robotronik/cdfr2024-carte-asservissement/README.md

# Carte d'asservissement Robotronik CDFR 2024

Projet Kicad qui a pour but de faire l'asservissement de la base roulante.
