robotronik/cdfr2024-carte-asservissement/cdfr25_imu/cdfr25_imu.kicad_pcb

## KiCad design cdfr25_imu/cdfr25_imu.kicad_pcb (2024-10-16)

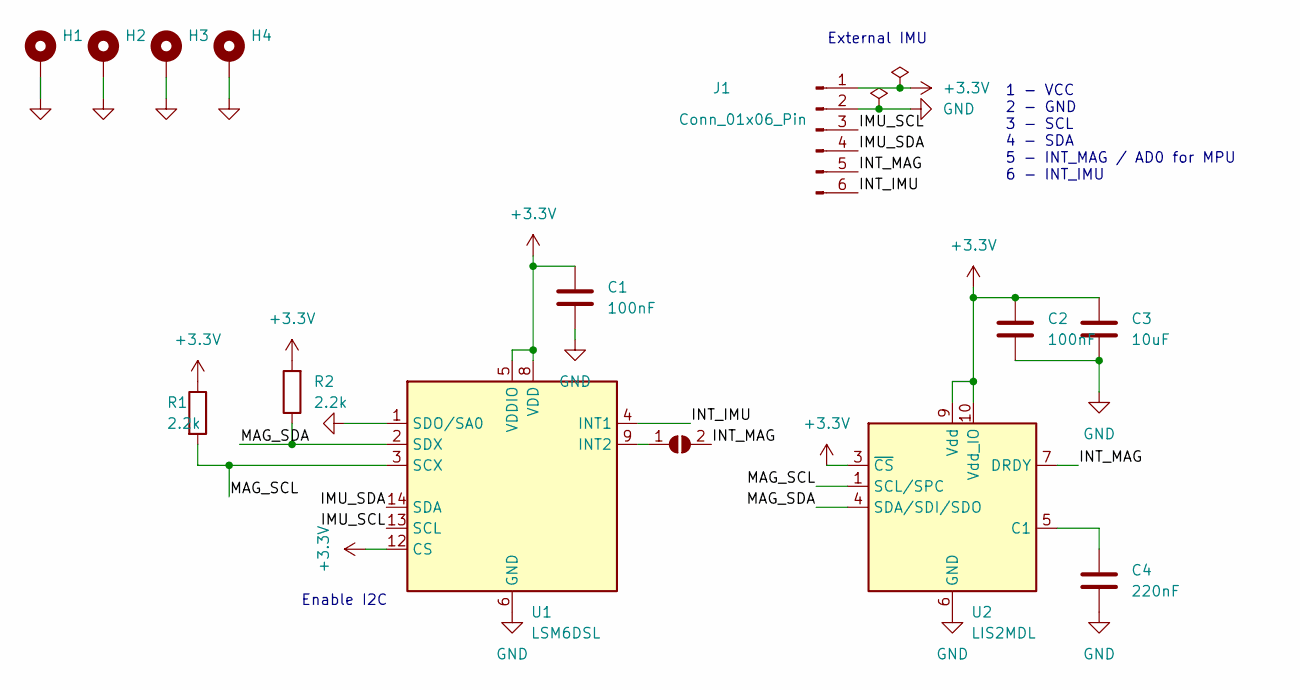
[picture p1: schematic cdfr25_imu.kicad_sch]

Parts:
C1, C2: 100nF; C_0805_2012Metric_Pad1.18x1.45mm_HandSolder
C3: 10uF; C_0805_2012Metric_Pad1.18x1.45mm_HandSolder
C4: 220nF; C_0805_2012Metric_Pad1.18x1.45mm_HandSolder
H1, H2, H3, H4: MountingHole_Pad; MountingHole_2.2mm_M2_Pad_Via
J1: Conn_01x06_Pin; PinHeader_1x06_P2.54mm_Vertical
JP1: SolderJumper_2_Open; SolderJumper-2_P1.3mm_Open_TrianglePad1.0x1.5mm
R1, R2: 2.2k; R_0805_2012Metric_Pad1.20x1.40mm_HandSolder
U1: LSM6DSL; LGA-14_3x2.5mm_P0.5mm_LayoutBorder3x4y
U2: LIS2MDL; LGA-12_2x2mm_P0.5mm

Connections:
+3.3V: C1.2, C2.2, C3.2, J1.1, R1.1, R2.2, U1.5 (VDDIO), U1.8 (VDD), U1.12 (CS), U2.3 (~CS), U2.9 (Vdd), U2.10 (Vdd_IO)
/IMU_SCL: J1.3, U1.13 (SCL)
/IMU_SDA: J1.4, U1.14 (SDA)
/INT_IMU: J1.6, U1.4 (INT1)
/INT_MAG: J1.5, JP1.2 (B), U2.7 (DRDY)
/MAG_SCL: R1.2, U1.3 (SCX), U2.1 (SCL/SPC)
/MAG_SDA: R2.1, U1.2 (SDX), U2.4 (SDA/SDI/SDO)
GND: C1.1, C2.1, C3.1, C4.1, H1.1, H2.1, H3.1, H4.1, J1.2, U1.1 (SDO/SA0), U1.6 (GND), U1.7 (GND), U2.6 (GND), U2.8 (GND)
unnamed: JP1.1 (A), U1.9 (INT2)
unnamed: C4.2, U2.5 (C1)

Notes on the sheet:
External IMU
Enable I2C
1 - VCC 2 - GND 3 - SCL 4 - SDA 5 - INT_MAG / AD0 for MPU 6 - INT_IMU

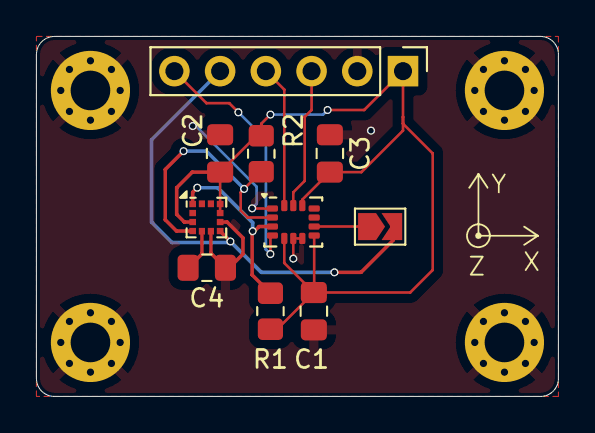
[picture p2: board cdfr25_imu.kicad_pcb from above]

Board: 2 copper layers, 29.0 x 20.0 mm, 14 parts (0 on the bottom side), 10 nets.
