robotronik/cdfr2024-carte-asservissement/cdfr24_asservissement/cdfr24_asservissement.kicad_pcb

## KiCad design cdfr24_asservissement/cdfr24_asservissement.kicad_pcb (2024-10-13)

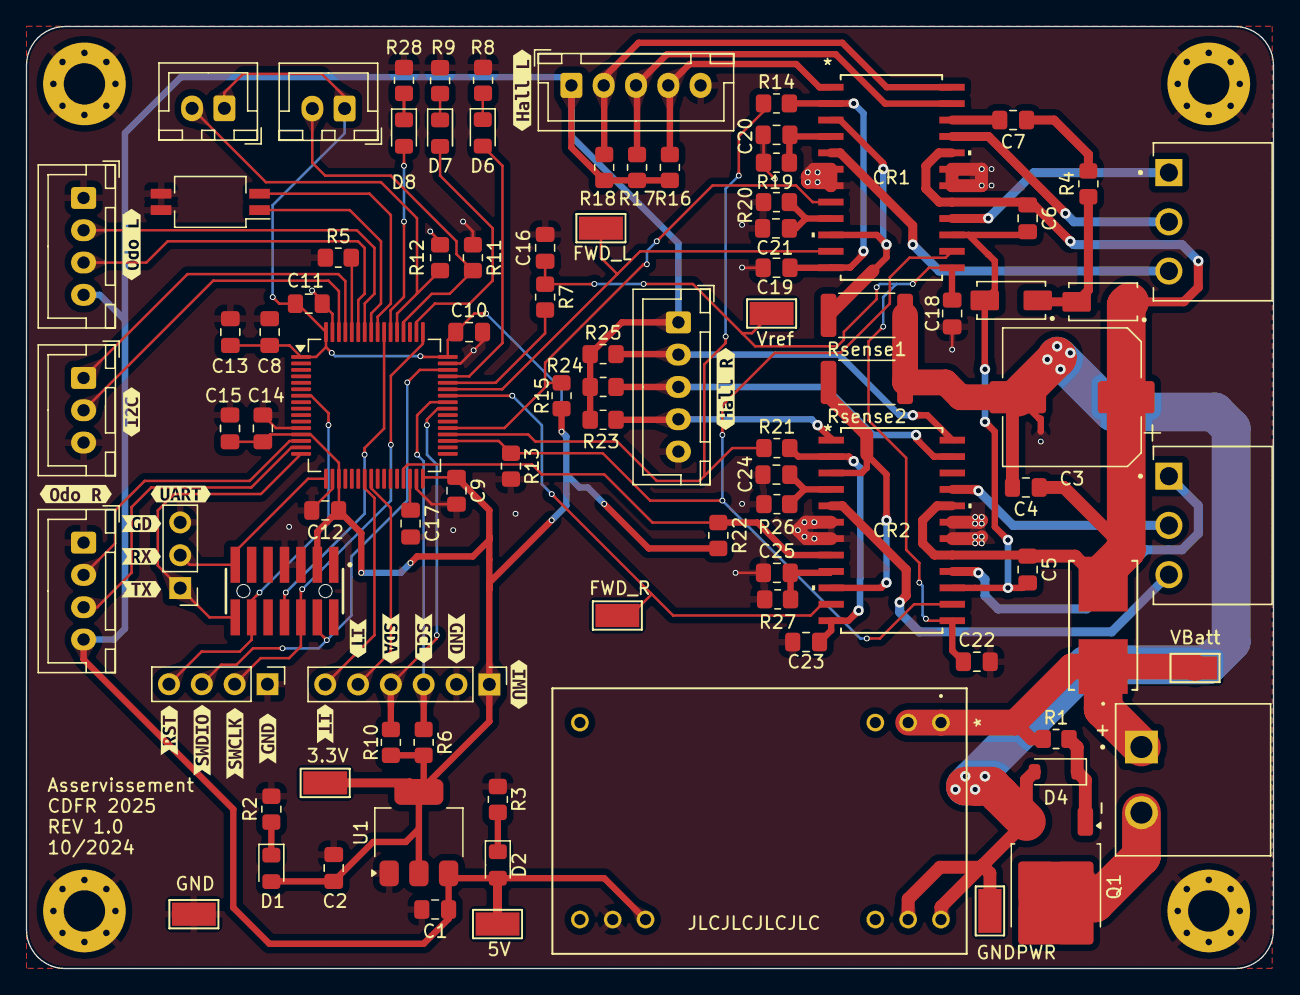
[picture p3: board cdfr24_asservissement.kicad_pcb from above]

Board: 2 copper layers, 96.5 x 72.9 mm, 117 parts (0 on the bottom side), 70 nets.

Parts:
C1, C8, C9, C10, C11, C12: 100nF; C_0805_2012Metric_Pad1.18x1.45mm_HandSolder
C2, C13: 10uF; C_0805_2012Metric_Pad1.18x1.45mm_HandSolder
C3: 220u; CP_Elec_10x10.5
C4, C5, C6, C18, C22: 100n; C_0805_2012Metric_Pad1.18x1.45mm_HandSolder
C7: 10n; C_0805_2012Metric_Pad1.18x1.45mm_HandSolder
C14, C21, C25: 10nF; C_0805_2012Metric_Pad1.18x1.45mm_HandSolder
C15: 1uF; C_0805_2012Metric_Pad1.18x1.45mm_HandSolder
C16: ...; C_0805_2012Metric_Pad1.18x1.45mm_HandSolder
C17: 4.7uF; C_0805_2012Metric_Pad1.18x1.45mm_HandSolder
C19, C23: 5.6n; C_0805_2012Metric_Pad1.18x1.45mm_HandSolder
C20, C24: 1nF; C_0805_2012Metric_Pad1.18x1.45mm_HandSolder
CR1, CR2: L6235D; SO-24_STM
D1, D2, D6, D7, D8: LED; LED_0805_2012Metric_Pad1.15x1.40mm_HandSolder
D3, D5: D_Filled; DIOM505270X240
D4: D_Zener; D_SOD-123
F1: 01550900M; FUSE_01550900M_LTF
H1, H2, H3, H4: MountingHole_Pad; MountingHole_3.2mm_M3_Pad_Via
J1: Connecteur batterie; CUI_TBP01R1-508-02BE
J2, J6: Conn_01x05; JST_XH_B5B-XH-A_1x05_P2.50mm_Vertical
J3, J8: Conn_01x03; CUI_TBP02R1-381-03BE
J4: Conn_01x06_Pin; PinHeader_1x06_P2.54mm_Vertical
J5: Conn_ST_STDC14; SAMTEC_FTSH-107-01-L-DV-K-A
J7: Connecteur Programmation; PinHeader_1x04_P2.54mm_Vertical
J9, J11: Connecteur Odométrie; JST_XH_B4B-XH-A_1x04_P2.50mm_Vertical
J10: Conn_01x03; PinHeader_1x03_P2.54mm_Vertical
J12: Conn_01x03; JST_XH_B3B-XH-A_1x03_P2.50mm_Vertical
J13, J14: Conn_01x02; JST_XH_B2B-XH-A_1x02_P2.50mm_Vertical
NT1: NetTie_2; NetTie-2_SMD_Pad0.5mm
Q1: Q_NMOS_GDS; TO-252-2
R1: 56k; R_0805_2012Metric_Pad1.20x1.40mm_HandSolder
R2, R3: 150; R_0805_2012Metric_Pad1.20x1.40mm_HandSolder
R4: 100; R_0805_2012Metric_Pad1.20x1.40mm_HandSolder
R5, R11, R12, R13, R15, R16, R17, R18, R22, R23, R24, R25: 10k; R_0805_2012Metric_Pad1.20x1.40mm_HandSolder
R6, R10: 2.2k; R_0805_2012Metric_Pad1.20x1.40mm_HandSolder
R7: ...; R_0805_2012Metric_Pad1.20x1.40mm_HandSolder
R8, R9, R28: 220; R_0805_2012Metric_Pad1.20x1.40mm_HandSolder
R14, R21: 100k; R_0805_2012Metric_Pad1.20x1.40mm_HandSolder
R19, R26: 33k; R_0805_2012Metric_Pad1.20x1.40mm_HandSolder
R20, R27: 47k; R_0805_2012Metric_Pad1.20x1.40mm_HandSolder
Rsense1, Rsense2: 0.15; R_2512_6332Metric
SW1: SW_DIP_x02; SW_DIP_SPSTx02_Slide_Copal_CHS-02B_W7.62mm_P1.27mm
TP1, TP2, TP3, TP4, TP5, TP6, TP7, TP8: TestPoint; TestPoint_Keystone_5015_Micro-Minature
U1: LD1117S33TR_SOT223; SOT-223-3_TabPin2
U2: TVN 5-2411WI; TVN_5WI_SINGLE_TRP
U3: STM32F401RCTx; LQFP-64_10x10mm_P0.5mm
kibuzzard-670C1B62: G***; kibuzzard-670C1B62
kibuzzard-670C1B77: G***; kibuzzard-670C1B77
kibuzzard-670C1BB6: G***; kibuzzard-670C1BB6
kibuzzard-670C1BE0: G***; kibuzzard-670C1BE0
kibuzzard-670C1C38: G***; kibuzzard-670C1C38
kibuzzard-670C1C44: G***; kibuzzard-670C1C44
kibuzzard-670C1C88: G***; kibuzzard-670C1C88
kibuzzard-670C1CA4: G***; kibuzzard-670C1CA4
kibuzzard-670C1CC0: G***; kibuzzard-670C1CC0
kibuzzard-670C1CCE: G***; kibuzzard-670C1CCE
kibuzzard-670C1CDC: G***; kibuzzard-670C1CDC
kibuzzard-670C1D0C: G***; kibuzzard-670C1D0C
kibuzzard-670C1D6D: G***; kibuzzard-670C1D6D
kibuzzard-670C1D22: G***; kibuzzard-670C1D22
kibuzzard-670C1D36: G***; kibuzzard-670C1D36
kibuzzard-670C1D87: G***; kibuzzard-670C1D87
kibuzzard-670C1D91: G***; kibuzzard-670C1D91
kibuzzard-670C1DC2: G***; kibuzzard-670C1DC2
kibuzzard-670C1DD5: G***; kibuzzard-670C1DD5

Connections:
+3.3V: C2.1, C8.1, C9.1, C10.1, C11.1, C12.1, C13.1, C14.1, C15.1, D1.2 (A), J4.1, J5.3 (VCC), J13.1, J14.1, R6.2, R10.2, R15.2, R22.2, TP1.1, U1.2 (VO), U3.1 (VBAT), U3.13 (VREF+), U3.19 (VDD), U3.32 (VDD), U3.48 (VDD), U3.64 (VDD)
+5V: C1.1, D2.2 (A), J2.1, J6.1, J9.4, J11.4, R16.1, R17.1, R18.1, R23.1, R24.1, R25.1, TP4.1, U1.3 (VI), U2.15 (+VOUT)
+BATT: F1.1, J1.1, R1.1, TP2.1, U2.1 (+VIN(VCC)), U2.2 (+VIN(VCC))
/BRAKE_MOT: CR1.14 (BRAKE), CR2.14 (BRAKE), R13.2, U3.35 (PB14)
/EN_MOT: R14.1, R21.1, U3.36 (PB15)
/FWD_L: CR1.11 (FWD/REV), TP6.1, U3.43 (PA10)
/FWD_R: CR2.11 (FWD/REV), TP8.1, U3.42 (PA9)
/I2C_CLK: J12.1, U3.61 (PB8)
/I2C_SDA: J12.2, U3.62 (PB9)
/IMU_SCL: J4.3, R6.1, U3.41 (PA8)
/IMU_SDA: J4.4, R10.1, U3.40 (PC9)
/INT_IMU: J4.6, U3.23 (PA7)
/INT_MAG: J4.5, U3.24 (PC4)
/RX: J5.13 (VCP_RX), J10.2, U3.17 (PA3)
/TACHO_L: CR1.8 (TACHO), R15.1, U3.37 (PC6)
/TACHO_R: CR2.8 (TACHO), R22.1, U3.29 (PB10)
/TX: J5.14 (VCP_TX), J10.1, U3.16 (PA2)
/Vboot: C5.2, C6.2, CR1.15 (VBOOT), CR2.15 (VBOOT), D5.1 (K)
/Vcp_L: C7.2, CR1.22 (VCP)
/Vref_DAC: C16.1, C18.1, C22.1, CR1.13 (VREF), CR2.13 (VREF), R7.1, TP7.1
/Vsab: C3.1, C4.1, C5.1, C6.1, CR1.17 (VSB), CR1.20 (VSA), CR2.17 (VSB), CR2.20 (VSA), D3.2 (A), F1.2
/left_driver/H1: CR1.1 (H1), J2.4, R16.2
/left_driver/H2: CR1.23 (H2), J2.3, R17.2
/left_driver/H3: CR1.24 (H3), J2.2, R18.2
/left_driver/OUT1: CR1.5 (OUT1), J3.3
/left_driver/OUT2: CR1.21 (OUT2), J3.2
/left_driver/OUT3: CR1.16 (OUT3), J3.1
/right_driver/H1: CR2.1 (H1), J6.4, R23.2
/right_driver/H2: CR2.23 (H2), J6.3, R24.2
/right_driver/H3: CR2.24 (H3), J6.2, R25.2
/right_driver/OUT1: CR2.5 (OUT1), J8.3
/right_driver/OUT2: CR2.21 (OUT2), J8.2
/right_driver/OUT3: CR2.16 (OUT3), J8.1
GND: C1.2, C2.2, C8.2, C9.2, C10.2, C11.2, C12.2, C13.2, C14.2, C15.2, C16.2, C17.2, C18.2, C19.1, C20.1, C21.1, C22.2, C23.1, C24.1, C25.1, CR1.6 (GND), CR1.7 (GND), CR1.18 (GND), CR1.19 (GND), CR2.6 (GND), CR2.7 (GND), CR2.18 (GND), CR2.19 (GND), H1.1, H2.1, H3.1, H4.1, J2.5, J4.2, J5.5 (GND), J5.7 (GND), J6.5, J7.1, J9.1, J10.3, J11.1, J12.3, NT1.2, R2.2, R3.2, R5.1, R8.2, R9.2, R11.1, R12.1, R13.1, R19.1, R20.1, R26.1, R27.1, R28.2, SW1.3, SW1.4, TP5.1, U1.1 (GND), U2.14 (-VOUT), U3.12 (VSSA), U3.18 (VSS), U3.31 (VSS), U3.47 (VSS), U3.63 (VSS)
GNDPWR: C3.2, C4.2, D4.2 (A), NT1.1, Q1.3 (S), Rsense1.1, Rsense2.1, TP3.1, U2.23 (-VIN(GND)), U2.24 (-VIN(GND))
unnamed: C7.1, R4.2
unnamed: C19.2, CR1.2 (DIAG), CR1.12 (EN), R14.2
unnamed: C20.2, CR1.4 (RCOFF), R19.2
unnamed: C21.2, CR1.9 (RCPULSE), R20.2
unnamed: CR1.3 (SENSEA), CR1.10 (SENSEB), Rsense1.2
unnamed: C23.2, CR2.2 (DIAG), CR2.12 (EN), R21.2
unnamed: C24.2, CR2.4 (RCOFF), R26.2
unnamed: C25.2, CR2.9 (RCPULSE), R27.2
unnamed: CR2.3 (SENSEA), CR2.10 (SENSEB), Rsense2.2
unnamed: D1.1 (K), R2.1
unnamed: D2.1 (K), R3.1
unnamed: D3.1 (K), D5.2 (A), R4.1
unnamed: D4.1 (K), Q1.1 (G), R1.2
unnamed: D6.2 (A), U3.45 (PA12)
unnamed: D6.1 (K), R8.1
unnamed: D7.2 (A), U3.50 (PA15)
unnamed: D7.1 (K), R9.1
unnamed: D8.2 (A), U3.54 (PD2)
unnamed: D8.1 (K), R28.1
unnamed: J1.2, Q1.2 (D)
unnamed: J9.2, U3.14 (PA0)
unnamed: J9.3, U3.15 (PA1)
unnamed: J11.2, U3.58 (PB6)
unnamed: J11.3, U3.59 (PB7)
unnamed: J13.2, R11.2, U3.52 (PC11)
unnamed: J14.2, R12.2, U3.53 (PC12)
unnamed: R5.2, U3.60 (BOOT0)
unnamed: R7.2, U3.44 (PA11)
unnamed: SW1.2, U3.56 (PB4)
unnamed: SW1.1, U3.57 (PB5)
unnamed: C17.1, U3.30 (VCAP1)
RST: J5.12 (~RST), J7.4, U3.7 (NRST)
SWCLK: J5.6 (JCLK/SWCLK), J7.2, U3.49 (PA14)
SWDIO: J5.4 (JTMS/SWDIO), J7.3, U3.46 (PA13)
SWO: J5.8 (JTDO/SWO), U3.55 (PB3)
