robotronik/cdfr2024-carte-asservissement/(commit log)

2023-11-01 Create project
    [cdfr24_asservissement.kicad_pcb, cdfr24_asservissement.kicad_sch]
2023-11-12 First draft of schematic
    [cdfr24_asservissement.kicad_sch, motor_driver.kicad_sch]
2023-11-18 change EXTI and boot0 pin connection
    [cdfr24_asservissement.kicad_sch, motor_driver.kicad_sch]
2023-11-18 new connecteur stlink
    [cdfr24_asservissement.kicad_sch]
2023-11-19 Add footprints
    [cdfr24_asservissement.kicad_pcb, cdfr24_asservissement.kicad_sch, motor_driver.kicad_sch]
2023-11-24 Place PCB components
    [cdfr24_asservissement.kicad_pcb, motor_driver.kicad_sch]
2023-11-27 Route PCB, still need to resolve DRC errors
    [cdfr24_asservissement.kicad_pcb]
2023-11-28 Resolve some errors
    [cdfr24_asservissement.kicad_pcb, cdfr24_asservissement.kicad_sch, motor_driver.kicad_sch]
2023-11-30 Fixed errors
    [cdfr24_asservissement.kicad_pcb]
2023-11-30 Remove lock
    [cdfr24_asservissement.kicad_pcb]
2023-12-07 correction Routage
    [cdfr24_asservissement.kicad_pcb, cdfr24_asservissement.kicad_sch, motor_driver.kicad_sch]
2024-01-04 Update via size
    [cdfr24_asservissement.kicad_pcb]
2024-09-04 Update gitignore
    [cdfr24_asservissement.kicad_pcb, cdfr24_asservissement.kicad_sch, motor_driver.kicad_sch]
2024-09-08 Add new components
    [cdfr24_asservissement.kicad_pcb, cdfr24_asservissement.kicad_sch, motor_driver.kicad_sch]
2024-09-09 Change 5v to 3.3v regulator to ST product
    [cdfr24_asservissement.kicad_pcb, cdfr24_asservissement.kicad_sch]
2024-09-10 Realign elements to grid
    [cdfr24_asservissement.kicad_sch, motor_driver.kicad_sch]
2024-09-12 Combine charge pump
    [cdfr24_asservissement.kicad_sch, motor_driver.kicad_sch]
2024-09-15 Change STM32 pins
    [cdfr24_asservissement.kicad_pcb, cdfr24_asservissement.kicad_sch, motor_driver.kicad_sch]
2024-09-17 Add low pass filter
    [cdfr24_asservissement.kicad_sch, motor_driver.kicad_sch]
2024-09-17 Add LEDs and remove capacitor
    [cdfr24_asservissement.kicad_sch]
2024-09-21 Fix warnings, add DIP switches
    [cdfr24_asservissement.kicad_sch, motor_driver.kicad_sch]
2024-09-22 Place components
    [cdfr24_asservissement.kicad_pcb, cdfr24_asservissement.kicad_sch, motor_driver.kicad_sch]
2024-09-24 Improve placement
    [cdfr24_asservissement.kicad_pcb, cdfr24_asservissement.kicad_sch, motor_driver.kicad_sch]
2024-09-25 Start routing
    [cdfr24_asservissement.kicad_pcb, cdfr24_asservissement.kicad_sch, motor_driver.kicad_sch]
2024-09-29 Finish routing
    [cdfr24_asservissement.kicad_pcb, cdfr24_asservissement.kicad_sch, motor_driver.kicad_sch]
2024-09-29 Add silkscreen and logo
    [cdfr24_asservissement.kicad_pcb, cdfr24_asservissement.kicad_sch, motor_driver.kicad_sch]
2024-10-13 Add text on PCB
    [cdfr24_asservissement.kicad_pcb, cdfr24_asservissement.kicad_sch]
2024-10-14 Add IMU schematic
    [cdfr25_imu.kicad_pcb, cdfr25_imu.kicad_sch]
2024-10-14 Route IMU
    [cdfr25_imu.kicad_pcb, cdfr25_imu.kicad_sch]
2024-10-15 Fix clearance problem
    [cdfr25_imu.kicad_pcb, cdfr25_imu.kicad_sch]
2024-10-16 Add marking
    [cdfr25_imu.kicad_pcb, cdfr25_imu.kicad_sch]
